sciguy14/DeepNote-Guitar-Hero-Bot/schematics/propeller board schematic.jpg

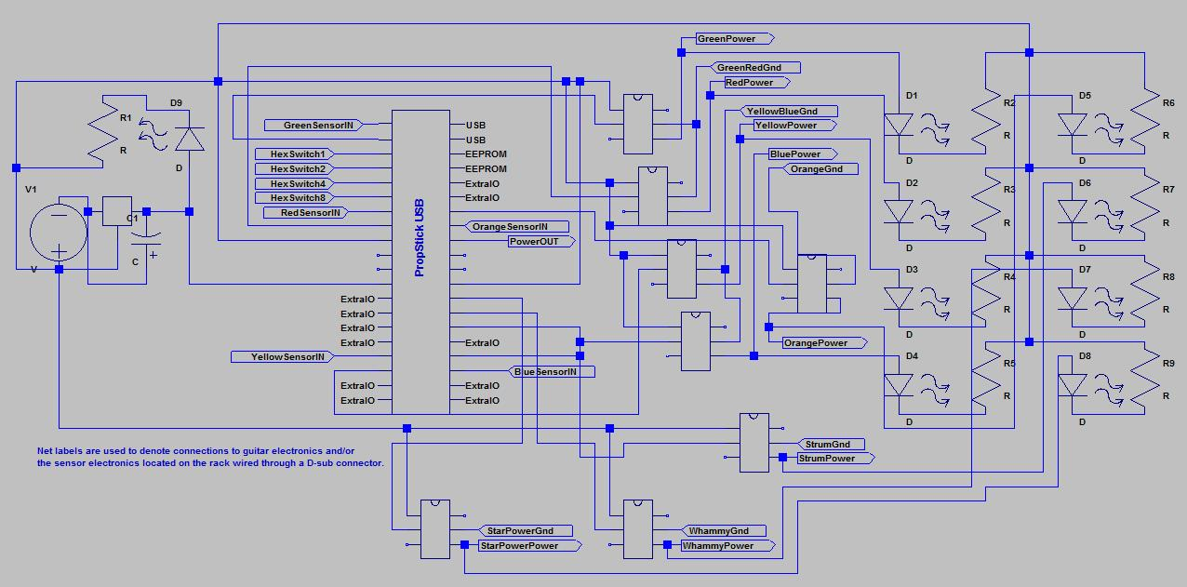
schematics/propeller board schematic.jpg
