sciguy14/DeepNote-Guitar-Hero-Bot/block diagram/Deepnote Block Diagram v2.jpg

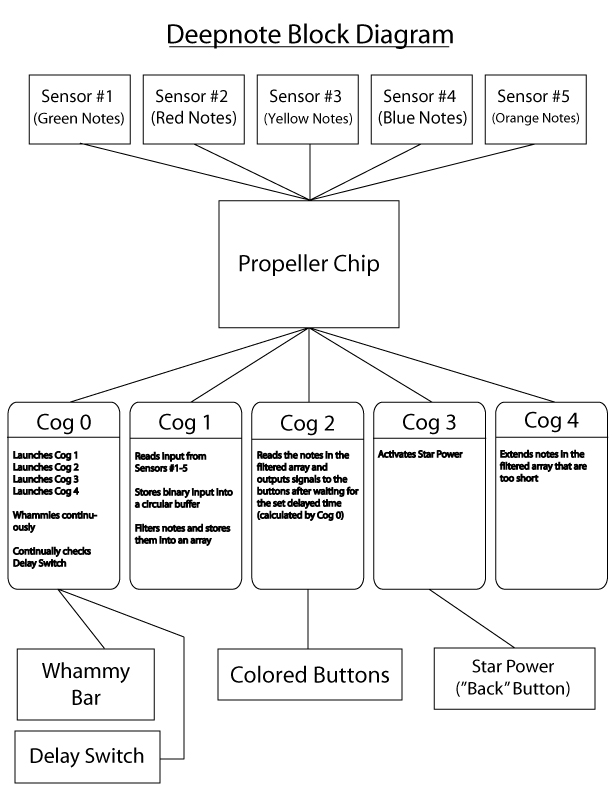
block diagram/Deepnote Block Diagram v2.jpg
