sciguy14/DeepNote-Guitar-Hero-Bot/schematics/sensor circuit schematic.JPG

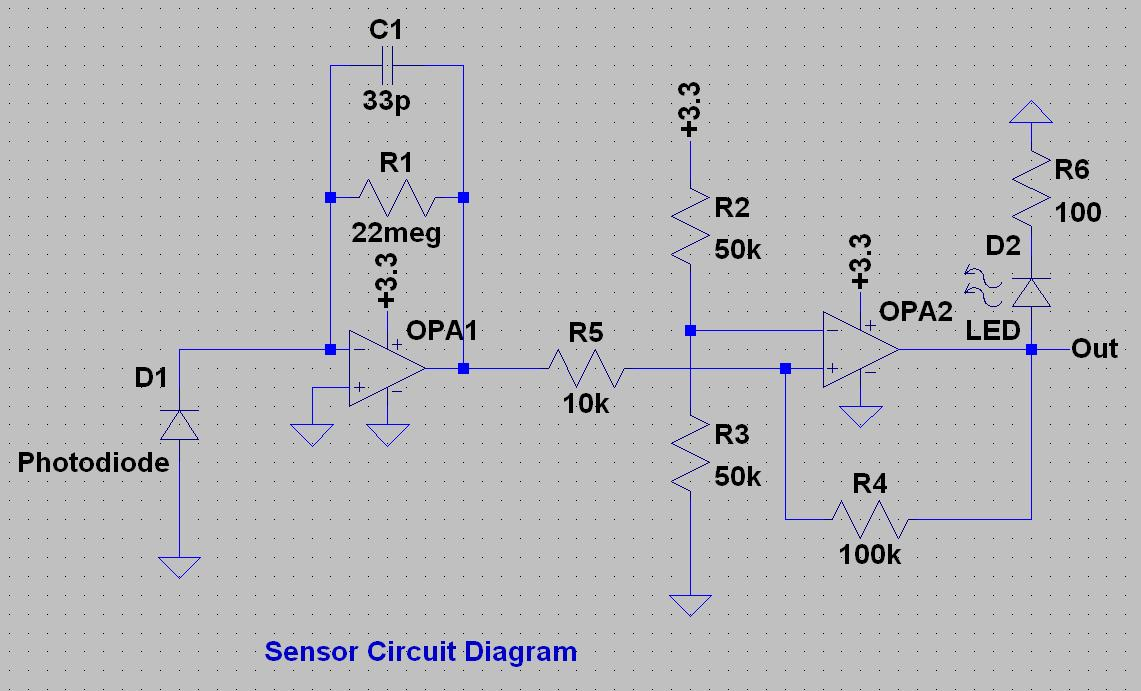
schematics/sensor circuit schematic.JPG
