sciguy14/DeepNote-Guitar-Hero-Bot/Parts List.pdf

### Bill of Materials

Part | Qty | URL | Part ID | Total Price
22MΩ Resistors | 5 | www.digikey.com | PPCHJ22MCT‐ND | $2.95
49.9KΩ Resistors | 10 | www.digikey.com | 49.9XBK‐ND | $0.98
100KΩ Resistors | 5 | www.digikey.com | 100KXBK‐ND | $0.49
10KΩ Resistors | 5 | www.digikey.com | 10.0KXBK‐ND | $0.49
33pF Capacitors | 5 | www.digikey.com | 1431PH‐ND | $0.95
Operational Amplifiers (OPA2340) | 5 | www.digikey.com | OPA2340PA‐ND | $11.16
Photodiodes | 5 | www.digikey.com | PDB‐C134‐ND | $6.47
Red LED | 10 | www.radioshack.com | 276‐309 | $14.90
Yellow LED | 1 | www.radioshack.com | 276‐021 | $1.49
Mountable LED (RED) | 1 | www.radioshack.com | 276‐011 | $2.59
100 ohm Resistors | 14 | www.digikey.com | 100XBK‐ND | $0.52
1000µF Capacitor | 1 | www.digikey.com | P5155‐ND | $0.25
5 volt Regulator | 1 | www.digikey.com | LM2940CT‐5.0‐ND | $1.82
Solid State Relays | 8 | www.digikey.com | 255‐1546‐5‐ND | $45.12
Sensor Printed Circuit Boards | 5 | www.4pcb.com | Custom | $15.00
Main Printed Circuit Board | 1 | www.4pcb.com | Custom | $25.00
Parallax Propller Prop‐Stick Education Kit | 1 | www.parallax.com | 32306 | $99.99
15 pin D‐sub Male Solder Connector | 2 | www.digikey.com | A32503‐ND | $6.12
10 ft. 15 pin D‐sub Cable (female‐female) | 1 | www.l‐com.com | CRMN15FF‐2.5 | $18.00
1 ft. mini‐B (male) to B (female) USB cable | 1 | www.usbfirewire.com | RR‐B2MB‐12 | $16.00
Panel Mount Rocker Switch | 1 | www.digikey.com | CK2012‐ND | $7.93
Slide Switch Kit | 1 | www.radioshack.com | 275‐327 | $5.99
Hexidecimal Selector Switch | 1 | www.digikey.com | CH240‐ND | $26.84
Hexidecimal Right Panel | 1 | www.digikey.com | CH190‐ND | $0.68
Hexidecimal Left Panel | 1 | www.digikey.com | CH191‐ND | $0.68
Size M Coax DC Jack Panel Mount with Switch | 1 | www.radioshack.com | 274‐1582 | $2.99
9volt Battery Holster | 1 | www.digikey.com | BH9V‐W‐ND | $0.86
22 AWG solid core wire 75ft | 2 | www.radioshack.com | 278‐1224 | $12.98
1/2 Ounce of solder | 4 | www.radioshack.com | 64‐026 | $15.96
Heat shrink Tubing (various sizes) | 1 | www.digikey.com | VFP‐KIT‐ND | $19.96
12 position Terminal Strip | 1 | www.radioshack.com | 274‐680 | $2.59
40 pin DIP Socket | 1 | www.digikey.com | A411‐ND | $1.93
Guitar Hero 3 for PC with controller | 1 | www.amazon.com | Guitar Hero 3 | $59.99
Vector 1U Rack | 1 | www.digikey.com | CCA‐10F/90 | $132.00
Vector Snap in Mount Card Guide (Pkg of 12) | 1 | www.digikey.com | CG2‐45S | $16.56
| | TOTAL | | $578.23
