sciguy14/DeepNote-Guitar-Hero-Bot/PCBs/PCB Design_ prop box REV2.pdf

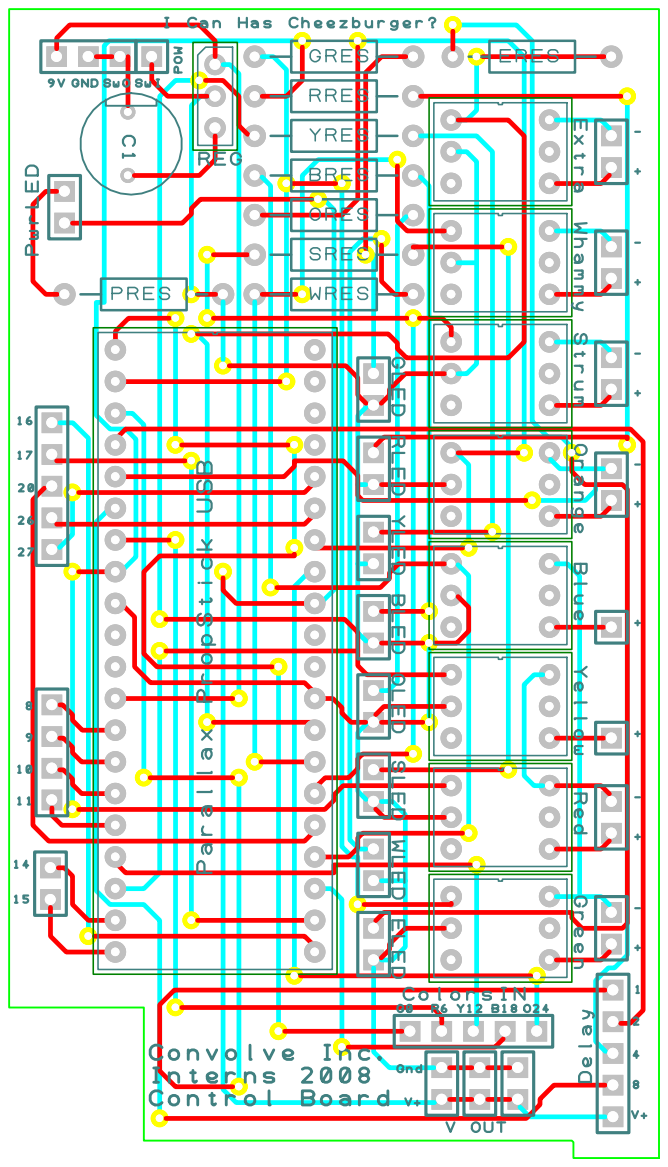
[picture p4: page 1]
