sciguy14/DeepNote-Guitar-Hero-Bot/PCBs/PCB Design_ sensor box.pdf

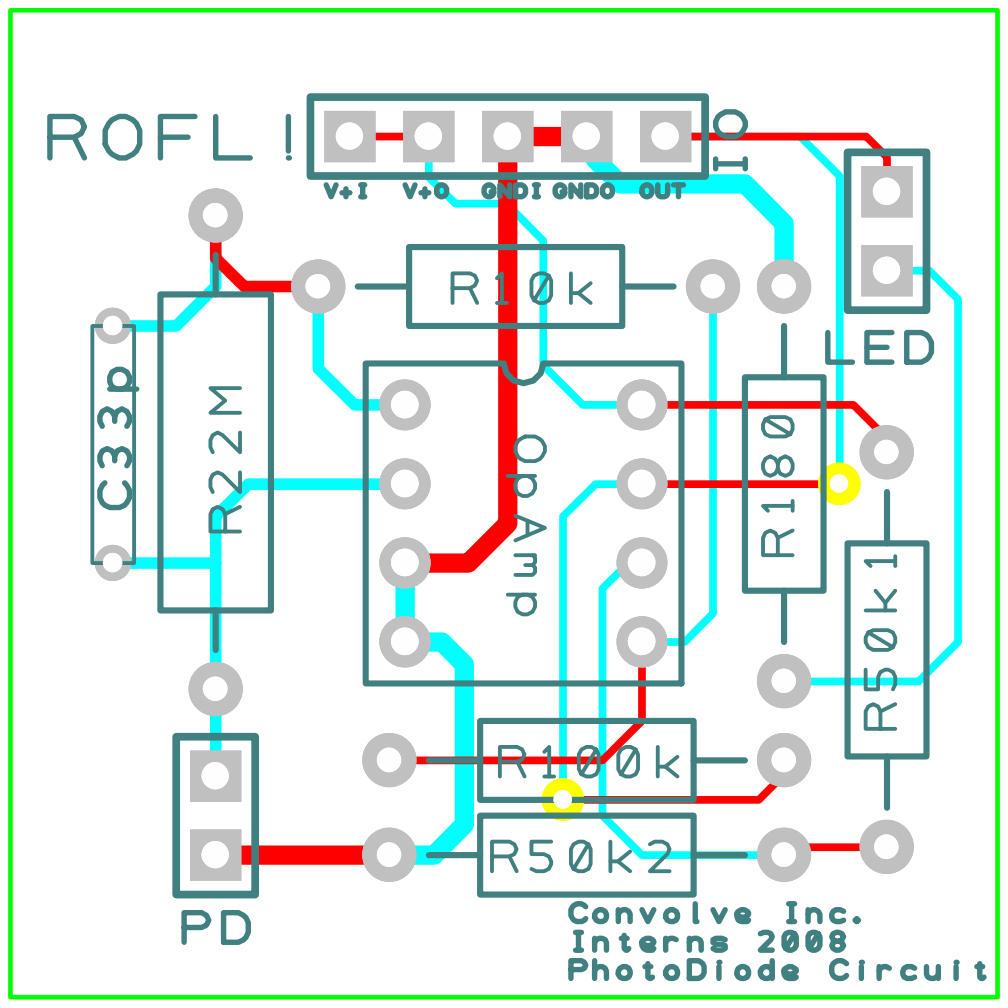
[picture p5: page 1]
