sciguy14/DeepNote-Guitar-Hero-Bot/(list of files, drawings)

Other design files:
PCBs/prop box REV2.pcb
PCBs/sensor box.pcb
